spirndai/ac-modbus-gateway/README.md

> [English](README.en.md) | **中文**

# ac-modbus-gateway

**不支持联网的中央空调，如何远程控制？——在总线上下手。**

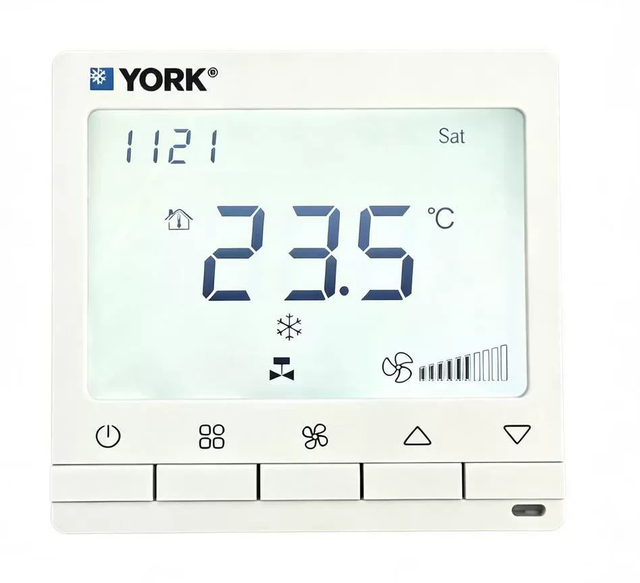
[picture p1: docs/images/mc2100.png]
约克 MC2100 面板


本方案针对约克（York）水系统中央空调（实测面板型号 **MC2100**，带 RS485 接口）：空调主机与各面板之间通过 RS485 Modbus RTU 总线通信，但厂家不提供（或高价提供）远程控制。我们在总线上并联一个 ESP32 网关，**监听**主机与面板之间的全部问答数据还原空调状态；需要控制时，在**总线空闲间隙**注入一帧标准 Modbus 写命令。Modbus RTU 帧中不存在发送者身份，协议层面没有来源校验，面板收到地址与 CRC 都合法的写命令即执行；实测确认这样下发的命令与人工操作面板效果完全一致，下一次主机轮询时面板正常上报新状态。

不改动空调主机与室内机、不碰厂家固件，原系统的通信完全不受影响。动手环节在面板上：数据可从面板背面预留的 RS485 口引出（不拆面板，需外接电源）；要省掉外接电源则可拆到面板内层引出 12V DC（见部署指南）。

> 本方案源于个人家庭使用（7 个面板），已稳定运行较长时间，命令注入策略经过实测验证。但它**不是工程化产品**，没有经过多环境验证，无法保证换个环境也能正常工作；作者也非空调/电子专业出身——请确认自己有足够的技术能力再尝试，接线错误、误触都可能烧毁设备，风险自担（见文末免责声明）。

## 方案特点

- **总线旁路，非侵入**：只并联监听总线；控制命令利用实测的总线空闲窗口注入，不影响原通信（空调设备和厂家固件不做任何改动）
- **采集**：开关机、运行模式（冷风/热风/换气/地暖/地暖热风）、设定温度、当前温度、风速、水泵状态
- **控制**：开关机、模式切换、设定温度、风速调节、水泵开关
- **协议逆向**：通过对比"面板操作 → 总线数据变化"还原寄存器含义（寄存器表见协议文档）
- **固件极简**：ESP32 只负责搬运原始帧（上报 + 空闲注入），解析、去重、存储全在服务器，改逻辑不用重烧固件
- **完整链路**：状态入库 PostgreSQL、手机网页查看与控制
- **自动寻址**：服务器从上报告包的源地址自动学习网关 IP（DHCP 变化无需配置），控制命令发回网关

## 架构

```
                     RS485 总线
      主机(主控) ◄───────┬────────► 面板（各自独立地址）
                       │
        并联监听（只读）+ 空闲时注入命令
                       │
                 ┌─────┴─────┐
                 │   ESP32   │  WiFi 网关 (firmware/)
                 └─────┬─────┘
          UDP:12333 上报│ ▲ UDP:12335 接收控制命令
                       ▼ │
                 ┌───────┴────┐     ┌────────────┐
                 │    svr     │────►│ PostgreSQL │
                 │ Modbus 解析 │     └────────────┘
                 │ 入库        │
                 └────────────┘
                 ┌────────────┐
                 │  websvr    │  浏览器/手机查看与控制
                 └────────────┘  （查数据库取状态，UDP 直发命令到网关）
```

## 文档

| 文档 | 内容 |
|---|---|
| [docs/principle.md](docs/principle.md) | **核心原理**：总线时序分析、空闲窗口注入策略、系统数据流设计 |
| [docs/protocol.md](docs/protocol.md) | **协议**：Modbus 帧结构、逆向方法、寄存器表、UDP 接口、数据库结构 |
| [docs/deployment.md](docs/deployment.md) | **部署**：硬件接线、固件烧录、服务器安装、调试排查 |

## 快速开始

```bash
# 服务器（改 docker-compose.yml 里的 your_db_password）
cd server && docker compose up -d

# 固件：Arduino IDE 打开 firmware/udp_to_modbus/udp_to_modbus.ino
# 修改顶部 WiFi / 服务器地址 / OTA 密码后编译烧录
```

浏览器访问 `http://<服务器IP>:9950` 查看和控制。详细步骤见 [docs/deployment.md](docs/deployment.md)。

> **语言说明**：文档为中文，Web 界面与消息文案也是中文。如需其他语言，建议直接把模板和字符串交给 AI（如 Claude）转换成你的语言——比给项目内建多语言机制更简单直接。

## 目录结构

```
firmware/udp_to_modbus/    ESP32 固件（Arduino，WiFi 版）
server/
  docker-compose.yml       服务编排
  svr/                     UDP 接收、Modbus 帧解析、入库
  websvr/                  Flask Web 界面（状态显示 + 控制）
docs/                      方案文档
```

## 免责声明

- 本项目源于**个人家庭使用**，已稳定运行较长时间，但**不是工程化产品**——没有经过多环境验证，无法保证在你的设备/环境下能正常运行
- 作者并非空调或电子专业出身，方案只是提供一个**参考思路**；请在有足够技术能力（拆机、接线、嵌入式、网络）的前提下再尝试
- 接线错误、接错电压、误触都可能**烧毁设备**（收发模块、ESP32，甚至空调面板），请自行评估风险
- 本项目为个人非官方项目，与约克（York）及相关厂商无任何关联，未获其授权或认可
- 协议与寄存器信息为对**本人在自有设备**上的通信总线观察、分析所得，仅供学习研究与互操作性用途
- 操作空调总线、修改运行参数（尤其水泵等寄存器）可能影响设备正常运行甚至造成损坏，并可能使设备失去保修，**风险自负**
- 本项目不包含任何厂商的固件、手册等受版权保护的内容

## License

[GPL-3.0](LICENSE)
